Alberto0235/DC-DC-Boost-Converter-Design/Simulations/Boost_Converter_With_Snubber.asc

C1: cap; 100µ; V=50 Irms=620m Rser=0.18
C2: cap; 22µ; V=50 Irms=195m Rser=0.91
C3: cap; 0.66n
D1: MBR760
L1: 1415440C
LOAD: res; 16.67
R1: res; 16
S1: STP16NF06L
SOURCE: voltage; 5
V2: voltage; PULSE(0 10 0 10n 10n {0.54*40u} 40u)
Named nets: 0, G, S, OUT, IN, Switching_node
.tran 0 6.2m 6m startup
.meas Vo AVG V(OUT)
.meas Io AVG I(LOAD)
.meas Pout AVG V(OUT)*I(LOAD)
.meas Pin AVG -V(IN)*I(SOURCE)
.meas Eff param Pout/pin
.meas ID AVG Ix(D1:1)
.meas IL AVG Ix(L1:1)
.meas IS AVG Ix(S1:D)
